wallago/canary/CHANGELOG.md

# Changelog

## 0.1.0 - 2026-10-22

### 🚀 Features

- *(ui)* Looking very nice
- *(slint)* Work on ui
- *(slint)* Add logo
- Render the screen with slint
- *(hardware)* Make first support
- *(firmware)* Add dynamic render for temp (wip)
- *(firmware)* Add feature of pinfind
- *(firmware/sensor)* Make it work
- *(firmware)* Add uart layer
- Init esp

### 🚜 Refactor

- *(hardware)* Remove for now
- *(firmware/sensor)* Add clear doc and comment
- *(firmware)* Make it looking cleaner

### ⚙️ Miscellaneous Tasks

- Initial commit by @wallago

## New Contributors
* @wallago made their first contribution

<!-- generated by git-cliff -->
