wallago/canary/firmware/src/display/mod.rs

//! Display bring-up for the Waveshare ESP32-S3 1.85" 360x360 round panel
//! (Sitronix ST77916 over QSPI).

use embedded_graphics::pixelcolor::Rgb565;
use esp_hal::{Blocking, delay::Delay, i2c::master::I2c, spi::master::SpiDmaBus};
use st77916::{ColorMode, DisplaySize, DriverResult, St77916, Unbuffered};

use self::{qspi::QspiInterface, tca9554::TcaReset};

mod qspi;
mod tca9554;

/// Visible width of the panel, in pixels.
pub(crate) const WIDTH: u16 = 360;

/// Visible height of the panel, in pixels. The glass is round, so the corners
/// of this square are never lit.
pub(crate) const HEIGHT: u16 = 360;

/// ST77916 over QSPI, reset via the TCA9554 expander, unbuffered RGB565 `DrawTarget`.
pub(crate) type PanelDisplay<'d> = St77916<QspiInterface<'d>, TcaReset<'d>, Unbuffered<Rgb565>>;

/// ST77916 power-on sequence for this panel.
/// This is the `vendor_specific_init_new` table from the official Waveshare
/// ESP32-S3-Touch-LCD-1.85C demo (`main/LCD_Driver/ST77916.c`).
#[rustfmt::skip]
const PANEL_INIT: &[(u8, &[u8], u16)] = &[
    (0x36, &[0x00], 0),  // MADCTL: row/col order, RGB
    (0x3A, &[0x55], 0),  // COLMOD: 16bpp RGB565
    (0xF0, &[0x28], 0),
    (0xF2, &[0x28], 0),
    (0x73, &[0xF0], 0),
    (0x7C, &[0xD1], 0),
    (0x83, &[0xE0], 0),
    (0x84, &[0x61], 0),
    (0xF2, &[0x82], 0),
    (0xF0, &[0x00], 0),
    (0xF0, &[0x01], 0),
    (0xF1, &[0x01], 0),
    (0xB0, &[0x56], 0),
    (0xB1, &[0x4D], 0),
    (0xB2, &[0x24], 0),
    (0xB4, &[0x87], 0),
    (0xB5, &[0x44], 0),
    (0xB6, &[0x8B], 0),
    (0xB7, &[0x40], 0),
    (0xB8, &[0x86], 0),
    (0xBA, &[0x00], 0),
    (0xBB, &[0x08], 0),
    (0xBC, &[0x08], 0),
    (0xBD, &[0x00], 0),
    (0xC0, &[0x80], 0),
    (0xC1, &[0x10], 0),
    (0xC2, &[0x37], 0),
    (0xC3, &[0x80], 0),
    (0xC4, &[0x10], 0),
    (0xC5, &[0x37], 0),
    (0xC6, &[0xA9], 0),
    (0xC7, &[0x41], 0),
    (0xC8, &[0x01], 0),
    (0xC9, &[0xA9], 0),
    (0xCA, &[0x41], 0),
    (0xCB, &[0x01], 0),
    (0xD0, &[0x91], 0),
    (0xD1, &[0x68], 0),
    (0xD2, &[0x68], 0),
    (0xF5, &[0x00, 0xA5], 0),
    (0xDD, &[0x4F], 0),
    (0xDE, &[0x4F], 0),
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
    (0x21, &[0x00], 0),       // INVON
    (0x11, &[0x00], 120),     // SLPOUT
    (0x29, &[0x00], 0),       // DISPON
];

/// Assemble and initialise the panel from an already-wired QSPI bus and I2C bus.
pub(crate) fn build<'d>(
    bus: SpiDmaBus<'d, Blocking>,
    i2c: I2c<'d, Blocking>,
    delay: &mut Delay,
) -> DriverResult<PanelDisplay<'d>, QspiInterface<'d>, TcaReset<'d>> {
    St77916::builder(
        QspiInterface::new(bus),
        TcaReset::new(i2c),
        DisplaySize::new(WIDTH, HEIGHT),
    )
    .with_init_commands(PANEL_INIT)
    .unbuffered::<Rgb565>()
    .build(ColorMode::Rgb565, delay)
}
