wallago/canary/firmware/src/ui.rs

//! The screen: the UI generated from `assets/ui.slint`, the platform Slint
//! runs on, and the bridge from its software renderer to the panel.
//!
//! Slint owns the layout now — nothing here draws a border, places a label or
//! wipes a box. This module only answers two questions Slint asks of a bare
//! board: what time is it, and where do rendered pixels go.

use alloc::{boxed::Box, rc::Rc};
use core::time::Duration;

use canary_core::prelude::*;
use embedded_graphics::{
    draw_target::DrawTarget,
    pixelcolor::{Rgb565, raw::RawU16},
    prelude::{Point, Size},
    primitives::Rectangle,
};
use esp_hal::{psram::Psram, time::Instant};
use slint::{
    PhysicalSize, PlatformError,
    platform::{
        Platform, WindowAdapter,
        software_renderer::{MinimalSoftwareWindow, RepaintBufferType, Rgb565Pixel},
    },
};

use crate::display;

/// Rust side of `assets/ui.slint`, generated by `build.rs`.
// Generated code: the workspace's doc and pedantic lints aren't ours to
// satisfy there, and regenerating it on every build makes fixing them futile.
#[allow(
    missing_debug_implementations,
    missing_docs,
    unreachable_pub,
    unused_qualifications,
    clippy::pedantic,
    clippy::missing_docs_in_private_items,
    clippy::expect_used,
    clippy::panic,
    clippy::unwrap_used
)]
pub(crate) mod generated {
    slint::include_modules!();
}

/// Slint's view of this board: one fixed window and the boot clock.
struct Panel {
    /// The only window; Slint asks for it once, when the UI is created.
    window: Rc<MinimalSoftwareWindow>,
}

impl Platform for Panel {
    fn create_window_adapter(&self) -> core::result::Result<Rc<dyn WindowAdapter>, PlatformError> {
        Ok(self.window.clone())
    }

    fn duration_since_start(&self) -> Duration {
        // `Instant`'s epoch is boot, which is exactly the zero Slint wants for
        // timers and animations.
        Duration::from_micros(Instant::now().duration_since_epoch().as_micros())
    }
}

/// Hand Slint the window it draws into, and start its clock.
///
/// # Errors
///
/// [`Error::Init`] if a platform has already been installed.
pub(crate) fn init() -> Result<Rc<MinimalSoftwareWindow>> {
    // `ReusedBuffer`: the panel's own RAM holds the last frame, so Slint
    // repaints only the lines that actually changed. On an unbuffered panel
    // that is the difference between a visible flicker and none.
    let window = MinimalSoftwareWindow::new(RepaintBufferType::ReusedBuffer);
    window.set_size(PhysicalSize::new(
        u32::from(display::WIDTH),
        u32::from(display::HEIGHT),
    ));

    slint::platform::set_platform(Box::new(Panel {
        window: Rc::clone(&window),
    }))
    .map_err(|_| Error::Init("slint platform"))?;

    Ok(window)
}

/// Carve the framebuffer out of PSRAM.
///
/// Slint draws whole curves at a time, so it needs the entire window in
/// memory — 253 KiB at this size, which internal SRAM cannot spare next to
/// the heap and the DMA buffers.
///
/// # Errors
///
/// [`Error::Init`] if PSRAM is absent or too small to hold a frame.
pub(crate) fn frame_buffer(psram: &Psram) -> Result<&'static mut [Rgb565Pixel]> {
    let pixels = usize::from(display::WIDTH) * usize::from(display::HEIGHT);
    let bytes = pixels * size_of::<Rgb565Pixel>();

    let (base, available) = psram.raw_parts();
    if available < bytes {
        return Err(Error::Init("psram too small for a frame"));
    }
    // Checked rather than assumed, so the cast below cannot be misaligned.
    if base.align_offset(align_of::<Rgb565Pixel>()) != 0 {
        return Err(Error::Init("psram base misaligned"));
    }

    // SAFETY: `raw_parts` hands back the whole mapped PSRAM window. Nothing
    // else claims it — no allocator is attached to that range — and this runs
    // once during bring-up, before the buffer is handed to anyone. Zeroing
    // first both initialises the memory (PSRAM powers up with garbage) and
    // leaves the first frame on a black background. `Rgb565Pixel` needs
    // 2-byte alignment; the window starts on a page boundary.
    // Alignment is checked above, not assumed, so the cast is sound.
    #[allow(clippy::cast_ptr_alignment)]
    unsafe {
        core::ptr::write_bytes(base, 0, bytes);
        Ok(core::slice::from_raw_parts_mut(
            base.cast::<Rgb565Pixel>(),
            pixels,
        ))
    }
}

/// Draw whatever changed since the last call, then push only the rectangles
/// that actually changed out to the panel.
///
/// `frame` is the whole window, and keeps its contents between calls: that is
/// what lets Slint repaint just the dirty parts.
///
/// # Errors
///
/// Propagates the first error the panel returned.
pub(crate) fn render<D>(
    window: &MinimalSoftwareWindow,
    display: &mut D,
    frame: &mut [Rgb565Pixel],
) -> core::result::Result<(), D::Error>
where
    D: DrawTarget<Color = Rgb565>,
{
    let stride = usize::from(display::WIDTH);
    let mut dirty = None;

    window.draw_if_needed(|renderer| {
        dirty = Some(renderer.render(frame, stride));
    });

    let Some(dirty) = dirty else {
        return Ok(());
    };

    let frame = &*frame;

    // The rectangles do not overlap, so every pixel goes out at most once.
    for (origin, size) in dirty.iter() {
        let (Ok(x), Ok(y)) = (usize::try_from(origin.x), usize::try_from(origin.y)) else {
            continue;
        };
        let (Ok(w), Ok(h)) = (usize::try_from(size.width), usize::try_from(size.height)) else {
            continue;
        };
        if w == 0 || h == 0 {
            continue;
        }

        // Rows are `stride` apart in the framebuffer; `fill_contiguous` wants
        // them back to back, so walk the rectangle row by row.
        let colors = (0..h).flat_map(|row| {
            let begin = (y + row) * stride + x;
            frame[begin..begin + w]
                .iter()
                .map(|p| Rgb565::from(RawU16::new(p.0)))
        });

        display.fill_contiguous(
            &Rectangle::new(
                Point::new(origin.x, origin.y),
                Size::new(size.width, size.height),
            ),
            colors,
        )?;
    }

    Ok(())
}
