wallago/canary/(commit log)

2026-08-22 feat(firmware): add uart layer
2026-08-22 feat(firmware/sensor): make it work
2026-08-23 refactor(firmware/sensor): add clear doc and comment
2026-10-24 feat(enclosure): add two-part OpenSCAD desk enclosure
    A rounded shell, with the screen arm leaning back 15 degrees over a foot,
    and a bent cover that closes its inner faces. The screen screws to the
    cover through the board's M2 inserts. The X6 bolts under it with its gas
    inlet facing out, in a chamber walled off from the board's heat. Adds
    `just stl` to export both parts to target/enclosure/.
    Claude-Session: https://claude.ai/code/session_01HHV4JsZE2GhaL9Af4x5RbT
2026-10-24 feat(enclosure): split the cover into screen and sensor covers
    Rev H, after a test print of the two-part cover:
    - The cover is now two parts, each held by four M2 screws.
    - The screen cover has no posts. The board's 4 mm brass standoffs rest
    on it, and the screws go straight into them, so the arm is 12.5 mm
    instead of 14.
    - The X6 mounts by its two M2 holes on the connector edge, with the
    connector toward the screen, on 1.5 mm standoffs. The window sits over
    the gas element, and a slot clears the connector and its plug.
    - `just stl` exports shell, screen_cover and sensor_cover.
    Claude-Session: https://claude.ai/co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
2026-10-24 fix(enclosure): move the single screen hole 1.5 mm inward
    A test fit of the screen cover showed the board's third brass standoff
    sits 1.5 mm closer to the other two than the drawing suggested.
    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
2026-10-24 fix(enclosure): raise the X6 to 4 mm standoffs, close the connector slot
    The connector no longer passes through the sensor cover. It and its plug
    sit in a blind pocket on the underside, leaving 1.25 mm of cover above.
    The X6 bolts are now M2x10.
    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
2026-10-24 fix(enclosure): move the X6 standoffs 0.5 mm toward the screen
    A test fit showed the gas element sitting 0.5 mm off the window centre.
    The X6 and its standoffs move; the window and the foot vents stay put.
    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
2026-10-24 feat(enclosure): seat a USB-C breakout for power under the X6
    The glued receptacle sleeve gives way to a 21.6 x 12.7 mm USB-C breakout
    lying on the foot's floor, held by two M2 bolts from below, its
    receptacle in a port at the back with an outside recess for the plug's
    overmould. A pigtail from it into the board's USB-C carries power and
    data, so the bottom debug opening goes, and the divider slot grows to
    take the pigtail and the X6 leads.
    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
2026-10-24 feat(enclosure): remove the wall between the screen and the sensor
    The screen arm and the foot are now one open space, so the lead slot
    through the wall goes too.
    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
2026-10-24 fix(enclosure): loosen the cover fit and leave room for insert collars
    The covers were tight in the shell; the clearance per side goes from 0.2
    to 0.4 mm. Each boss gets a shallow relief at its top for the plastic a
    melted heat-set insert pushes up, and the boss tops now meet the cover's
    underside instead of stopping one clearance short.
    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
2026-10-26 fix(enclosure): widen the insert bosses to 7 mm
    The bosses were 5.4 mm around a 3.5 mm insert, which left too little wall for a hot iron. 7 mm is about twice the insert.
    Claude-Session: https://claude.ai/code/session_01JHizxwtPJb1une2FdTiCDm
2026-10-26 fix(enclosure): give the covers real side clearance and centre the X6
    cover_region() shrank its sides as the clearance grew, leaving no side clearance in the foot and -0.4 mm in the arm. It now grows by the fit on every side but the outer face, 0.4 mm per side. The X6 moves 0.5 mm toward the back so its gas element sits centred in the window.
    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
2026-10-26 feat(enclosure): print the shell in two halves
    The shell splits where the two covers meet into shell_arm, printed face-down, and shell_foot, printed floor-down, so neither needs support. Two blocks on the arm half reach back over the foot floor and take M2 screws from underneath into heat-set inserts. The arm's insert bosses now run down to the face so they print without support. just stl exports both halves.
    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
2026-10-26 fix(enclosure): size the USB-C breakout holes for M3
    The breakout's mounting holes take M3, not M2. The floor holes are now 3.4 mm with a matching countersink, and the pads the board rests on are 6 mm.
    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
2026-10-26 fix(enclosure): lengthen the screen arm 4 mm for the USB-C plug
    The pigtail plug in the screen board's USB-C port didn't fit between the board and the floor. The arm is 76 mm instead of 72 and the screen sits 4 mm higher, with the top screws and the vents moving up with it.
    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
2026-10-26 fix(enclosure): leave a 1 mm gap in front of the screen
    The arm was exactly as deep as the face, board, standoffs and cover, so print tolerance pressed the face onto the panel and showed white pixels. screen_gap adds 1 mm; the standoffs hold the board against the cover.
    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
2026-10-26 fix(enclosure): centre the screen in its window
    After test fits the screen's three board holes move 0.5 mm left and 0.3 mm down, so the panel's black border no longer shows at the edge of the window.
    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
2026-10-26 feat(enclosure): hold the USB-C breakout with M3 heat-set inserts
    The breakout now sits on two bosses with M3 inserts (Ø4.5, 3 mm long), screwed from above, instead of bolts and nuts from below. The 2 mm floor can't hold a 3 mm insert, so the bosses rise 1 mm and their holes run through the floor; the board and the back-wall port move up 1 mm with them. Each boss has a relief for the plastic the insert pushes up. The two holes are 0.5 mm further apart after a test fit.
    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
2026-10-27 feat(ui): rotate simple pages and take over the screen on bad air
    Replace the single dense screen with three large pages that rotate every
    15 s: comfort (temperature and humidity gauges with one verdict), air
    quality as one word, and the gas readings. When CO, HCHO, VOCs or the
    air quality index cross a limit, an alert page with one tip replaces
    the rotation until the reading recovers.
    The comfort and alert rules live in canary-core::advice, with tests.
    Claude-Session: https://claude.ai/code/session_01VHfAVKVypEt7TciFEXbgm2
2026-10-27 fix(ui): draw gauges as dots so they fit in the heap
    The stroked arc paths are rasterised into heap-allocated cells, and the
    large air quality ring ran the 150 KiB heap out on the board. Rounded
    rectangles are drawn without allocating.
    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
2026-10-27 fix(ui): keep page headers at one height and drop the grey border
    Each page placed its title and dots at its own height, so they jumped
    when the rotation moved on. A shared PageHeader pins them in one place.
    The grey outer ring is gone: the round glass already frames the screen.
    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
